qosch/OtterIronProRedesign/ECAD/OtterIronProRedesign.kicad_pcb

## KiCad design ECAD/OtterIronProRedesign.kicad_pcb (2020-11-29)

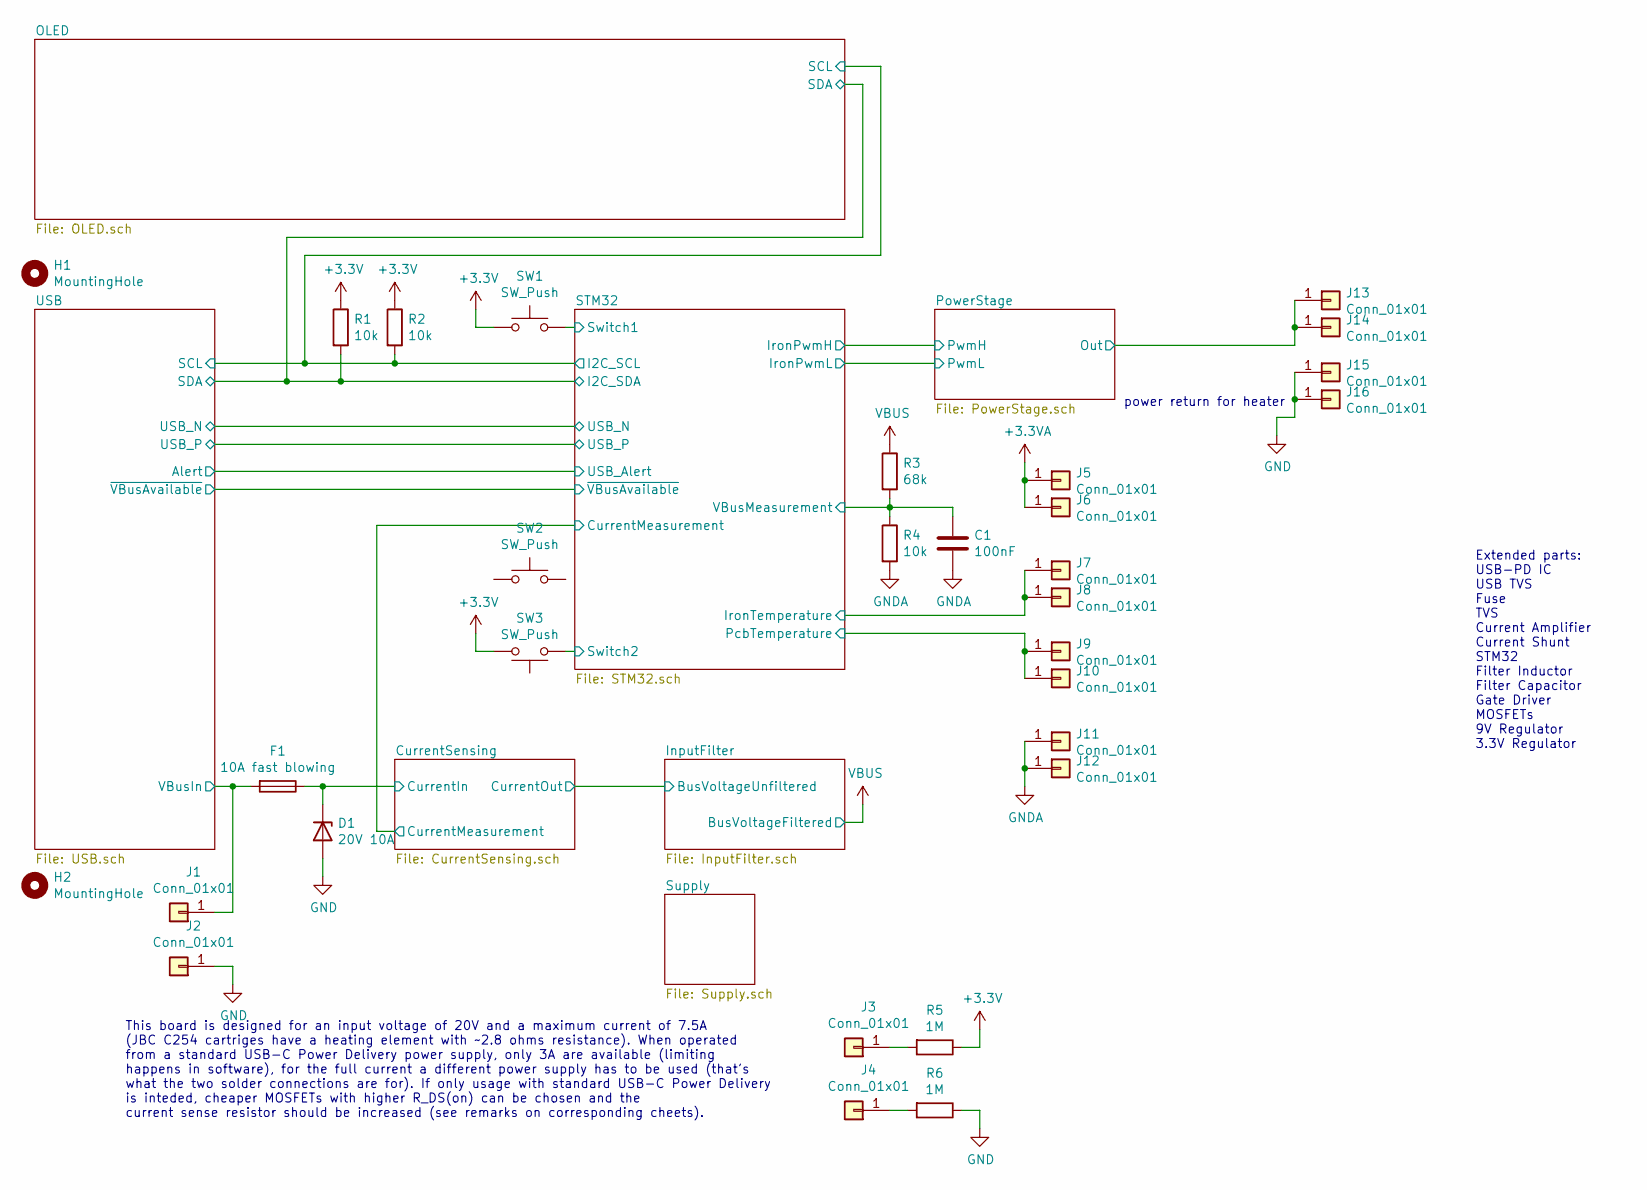
[picture p1: schematic OtterIronProRedesign.sch]

Parts:
C1: 100nF; C_0402_1005Metric
D1: 20V 10A; D_SMB; LCSC C309948
F1: 10A fast blowing; Fuse_1206_3216Metric; LCSC C182976
H1, H2: MountingHole; MountingHole_3.2mm_M3
J1, J2, J3, J4: Conn_01x01; TestPoint_Keystone_5019_Minature
J5, J6, J7, J8, J9, J10, J11, J12, J13, J14, J15, J16: Conn_01x01; TestPoint_Pad_3.0x3.0mm
R1, R2, R4: 10k; R_0402_1005Metric
R3: 68k; R_0402_1005Metric
R5, R6: 1M; R_0402_1005Metric
SW1, SW3: SW_Push; Panasonic_EVQPUL_EVQPUC; LCSC C388883
SW2: SW_Push; SW_Push_1P1T_NO_6x6mm_H9.5mm; LCSC C388883

Connections:
+3.3VA: J5.1, J6.1; also elsewhere on the board
+3V3: R1.1, R2.1, R5.1, SW1.1, SW3.2; also elsewhere on the board
/CurrentSensing/CurrentIn: D1.1 (K), F1.1; also elsewhere on the board
/PowerStage/Out: J13.1, J14.1; also elsewhere on the board
/STM32/I2C_SCL: R2.2; also elsewhere on the board
/STM32/I2C_SDA: R1.2; also elsewhere on the board
/STM32/IronTemperature: J7.1, J8.1; also elsewhere on the board
/STM32/PcbTemperature: J9.1, J10.1; also elsewhere on the board
/STM32/Switch1: SW1.2; also elsewhere on the board
/STM32/Switch2: SW3.1; also elsewhere on the board
/STM32/VBusMeasurement: C1.1, R3.2, R4.1; also elsewhere on the board
/USB/VBusIn: F1.2, J1.1; also elsewhere on the board
GND: D1.2 (A), J2.1, J15.1, J16.1, R6.1; also elsewhere on the board
GNDA: C1.2, J11.1, J12.1, R4.2; also elsewhere on the board
unnamed: J3.1, R5.2
unnamed: J4.1, R6.2
VBUS: R3.1; also elsewhere on the board

Notes on the sheet:
This board is designed for an input voltage of 20V and a maximum current of 7.5A (JBC C254 cartriges have a heating element with ~~2.8 ohms resistance). When operated from a standard USB-C Power Delivery power supply, only 3A are available (limiting happens in software), for the full current a diff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
power return for heater
Extended parts: USB-PD IC USB TVS Fuse TVS Current Amplifier Current Shunt STM32 Filter Inductor Filter Capacitor Gate Driver MOSFETs 9V Regulator 3.3V Regulator

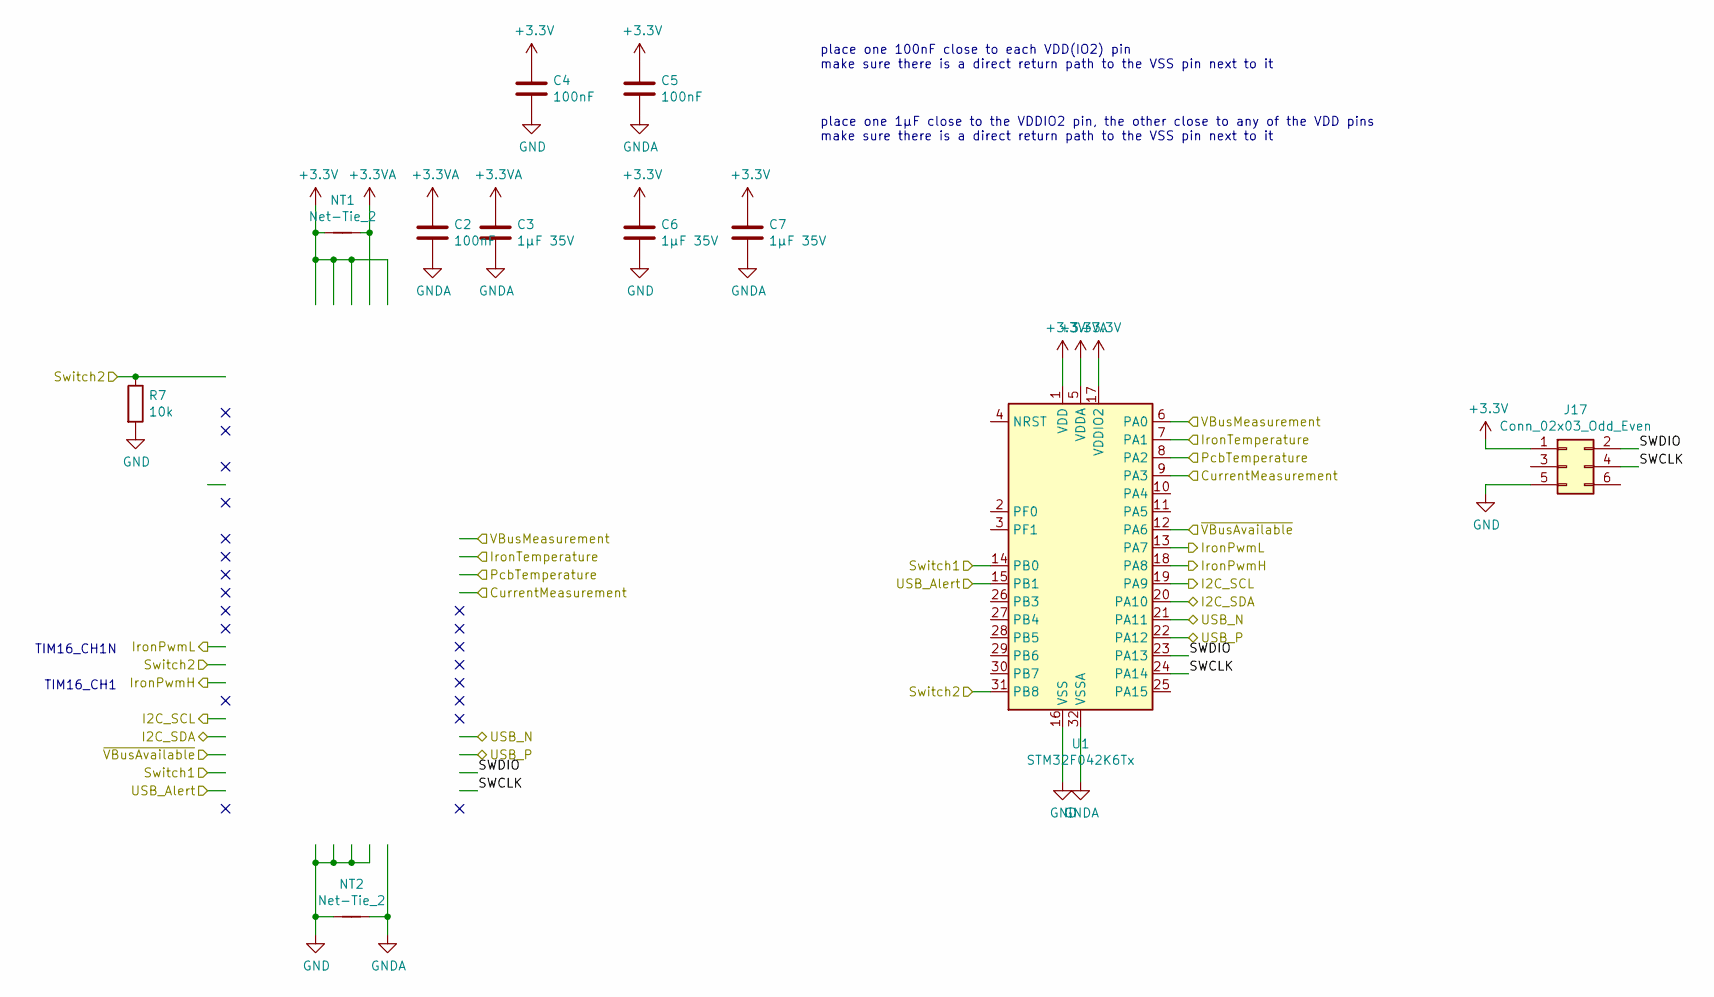
[picture p2: schematic STM32.sch]

Parts:
C2, C4, C5: 100nF; C_0402_1005Metric
C3, C6, C7: 1µF 35V; C_0402_1005Metric
J17: Conn_02x03_Odd_Even; Tag-Connect_TC2030-IDC-NL_2x03_P1.27mm_Vertical
NT1, NT2: Net-Tie_2; NetTie-2_SMD_Pad0.25mm
R7: 10k; R_0402_1005Metric
U1: STM32F042K6Tx; LQFP-32_7x7mm_P0.8mm

Connections:
+3.3VA: C2.1, C3.1, NT1.2, U1.5 (VDDA); also elsewhere on the board
+3V3: C4.1, C5.1, C6.1, C7.1, J17.1, NT1.1, U1.1 (VDD), U1.17 (VDDIO2); also elsewhere on the board
/CurrentSensing/CurrentMeasurement: U1.9 (PA3); also elsewhere on the board
/STM32/I2C_SCL: U1.19 (PA9); also elsewhere on the board
/STM32/I2C_SDA: U1.20 (PA10); also elsewhere on the board
/STM32/IronPwmH: U1.18 (PA8); also elsewhere on the board
/STM32/IronPwmL: U1.13 (PA7); also elsewhere on the board
/STM32/IronTemperature: U1.7 (PA1); also elsewhere on the board
/STM32/PcbTemperature: U1.8 (PA2); also elsewhere on the board
/STM32/SWCLK: J17.4, U1.24 (PA14)
/STM32/SWDIO: J17.2, U1.23 (PA13)
/STM32/Switch1: U1.14 (PB0); also elsewhere on the board
/STM32/Switch2: R7.1, U1.31 (PB8); also elsewhere on the board
/STM32/USB_N: U1.21 (PA11); also elsewhere on the board
/STM32/USB_P: U1.22 (PA12); also elsewhere on the board
/STM32/VBusMeasurement: U1.6 (PA0); also elsewhere on the board
/STM32/~VBusAvailable: U1.12 (PA6); also elsewhere on the board
/USB/Alert: U1.15 (PB1); also elsewhere on the board
GND: C4.2, C6.2, J17.5, NT2.1, R7.2, U1.16 (VSS); also elsewhere on the board
GNDA: C2.2, C3.2, C5.2, C7.2, NT2.2, U1.32 (VSSA); also elsewhere on the board

Notes on the sheet:
place one 100nF close to each VDD(IO2) pin make sure there is a direct return path to the VSS pin next to it
place one 1µF close to the VDDIO2 pin, the other close to any of the VDD pins make sure there is a direct return path to the VSS pin next to it
TIM16_CH1N
TIM16_CH1

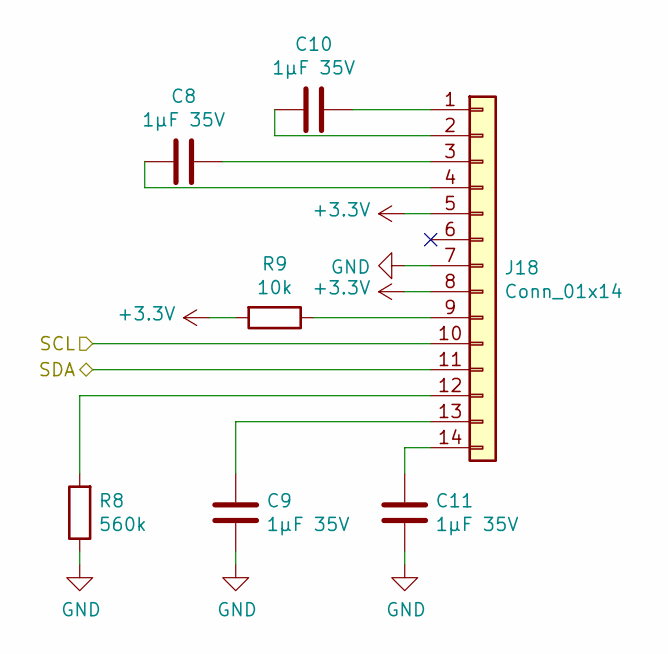
[picture p3: schematic OLED.sch]

Parts:
C8, C9, C10, C11: 1µF 35V; C_0402_1005Metric
J18: Conn_01x14; 0.69OLED
R8: 560k; R_0402_1005Metric
R9: 10k; R_0402_1005Metric

Connections:
+3V3: J18.5, J18.8, R9.2; also elsewhere on the board
/STM32/I2C_SCL: J18.10; also elsewhere on the board
/STM32/I2C_SDA: J18.11; also elsewhere on the board
GND: C9.2, C11.2, J18.7, R8.1; also elsewhere on the board
unnamed: C8.1, J18.3
unnamed: C8.2, J18.4
unnamed: C9.1, J18.13
unnamed: C10.1, J18.1
unnamed: C10.2, J18.2
unnamed: C11.1, J18.14
unnamed: J18.9, R9.1
unnamed: J18.12, R8.2

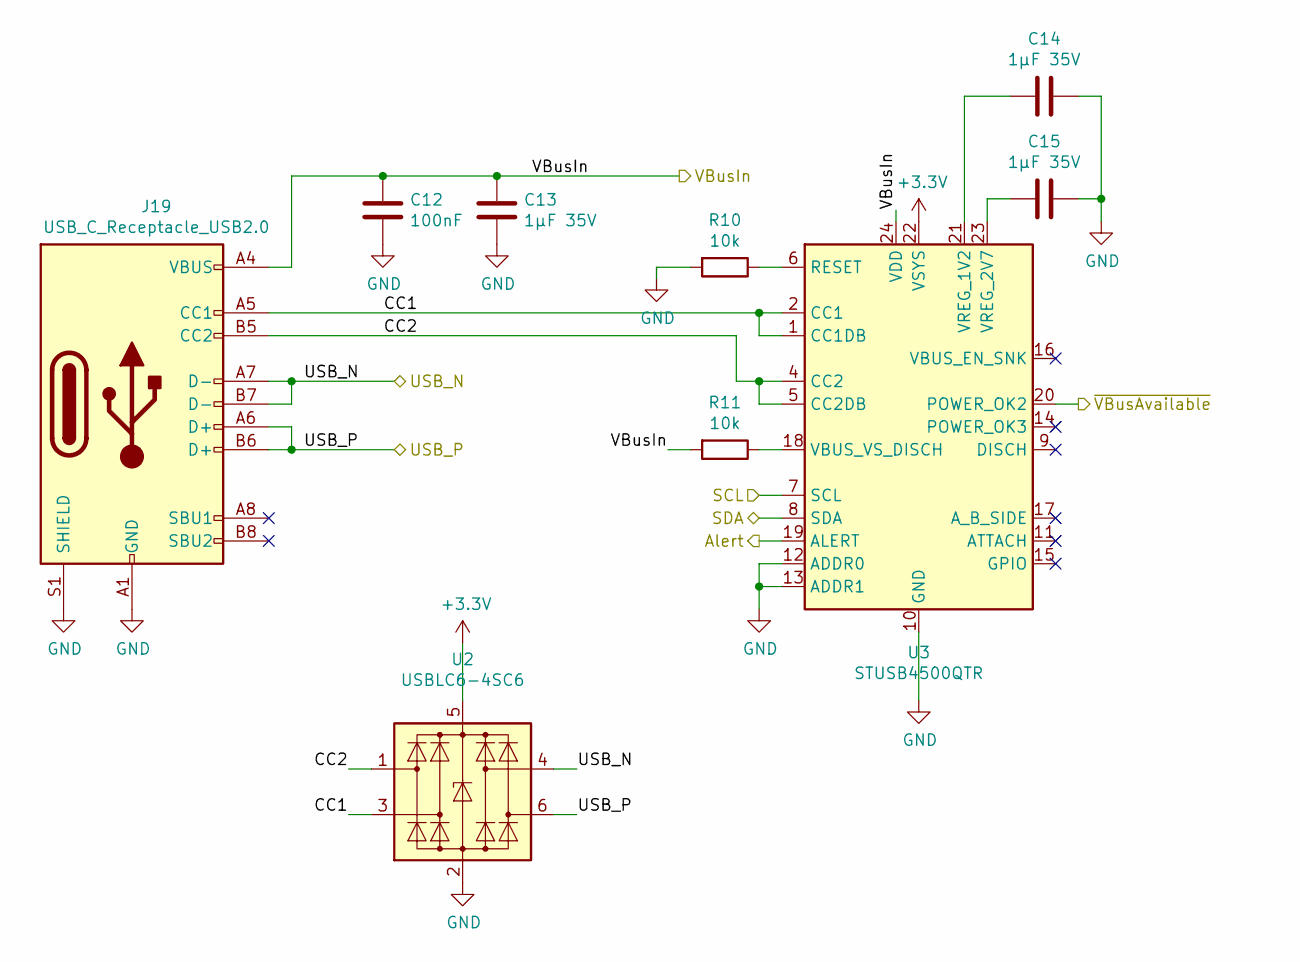
[picture p4: schematic USB.sch]

Parts:
C12: 100nF; C_0402_1005Metric
C13, C14, C15: 1µF 35V; C_0402_1005Metric
J19: USB_C_Receptacle_USB2.0; USB_C_Receptacle_XKB_U262-16XN-4BVC11; LCSC C167321
R10, R11: 10k; R_0402_1005Metric
U2: USBLC6-4SC6; SOT-23-6; LCSC C111212
U3: STUSB4500QTR; QFN-24-1EP_4x4mm_P0.5mm_EP2.7x2.7mm; LCSC C506650

Connections:
+3V3: U2.5 (VBUS), U3.22 (VSYS); also elsewhere on the board
/STM32/I2C_SCL: U3.7 (SCL); also elsewhere on the board
/STM32/I2C_SDA: U3.8 (SDA); also elsewhere on the board
/STM32/USB_N: J19.A7 (D-), J19.B7 (D-), U2.4 (I/O3); also elsewhere on the board
/STM32/USB_P: J19.A6 (D+), J19.B6 (D+), U2.6 (I/O4); also elsewhere on the board
/STM32/~VBusAvailable: U3.20 (POWER_OK2); also elsewhere on the board
/USB/Alert: U3.19 (ALERT); also elsewhere on the board
/USB/CC1: J19.A5 (CC1), U2.3 (I/O2), U3.1 (CC1DB), U3.2 (CC1)
/USB/CC2: J19.B5 (CC2), U2.1 (I/O1), U3.4 (CC2), U3.5 (CC2DB)
/USB/VBusIn: C12.1, C13.1, J19.A4 (VBUS), J19.A9 (VBUS), J19.B4 (VBUS), J19.B9 (VBUS), R11.2, U3.24 (VDD); also elsewhere on the board
GND: C12.2, C13.2, C14.1, C15.1, J19.A1 (GND), J19.A12 (GND), J19.B1 (GND), J19.B12 (GND), J19.S1 (SHIELD), R10.2, U2.2 (GND), U3.10 (GND), U3.12 (ADDR0), U3.13 (ADDR1), U3.25 (GND); also elsewhere on the board
unnamed: C14.2, U3.21 (VREG_1V2)
unnamed: C15.2, U3.23 (VREG_2V7)
unnamed: R10.1, U3.6 (RESET)
unnamed: R11.1, U3.18 (VBUS_VS_DISCH)

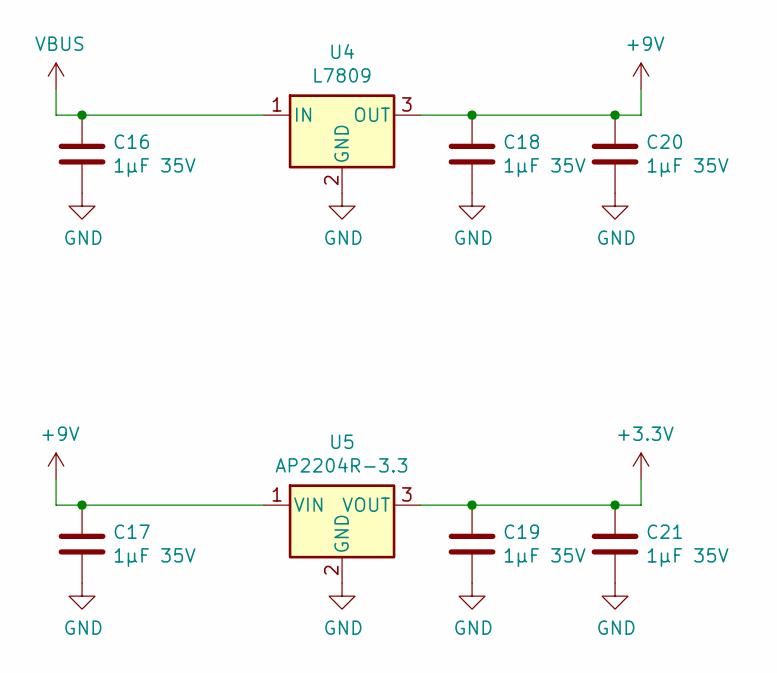
[picture p5: schematic Supply.sch]

Parts:
C16, C17, C18, C19, C20, C21: 1µF 35V; C_0402_1005Metric
U4: L7809; TO-252-2; LCSC C148310
U5: AP2204R-3.3; SOT-89-3

Connections:
+3V3: C19.1, C21.1, U5.3 (VOUT); also elsewhere on the board
+9V: C17.1, C18.1, C20.1, U4.3 (OUT), U5.1 (VIN); also elsewhere on the board
GND: C16.2, C17.2, C18.2, C19.2, C20.2, C21.2, U4.2 (GND), U5.2 (GND); also elsewhere on the board
VBUS: C16.1, U4.1 (IN); also elsewhere on the board

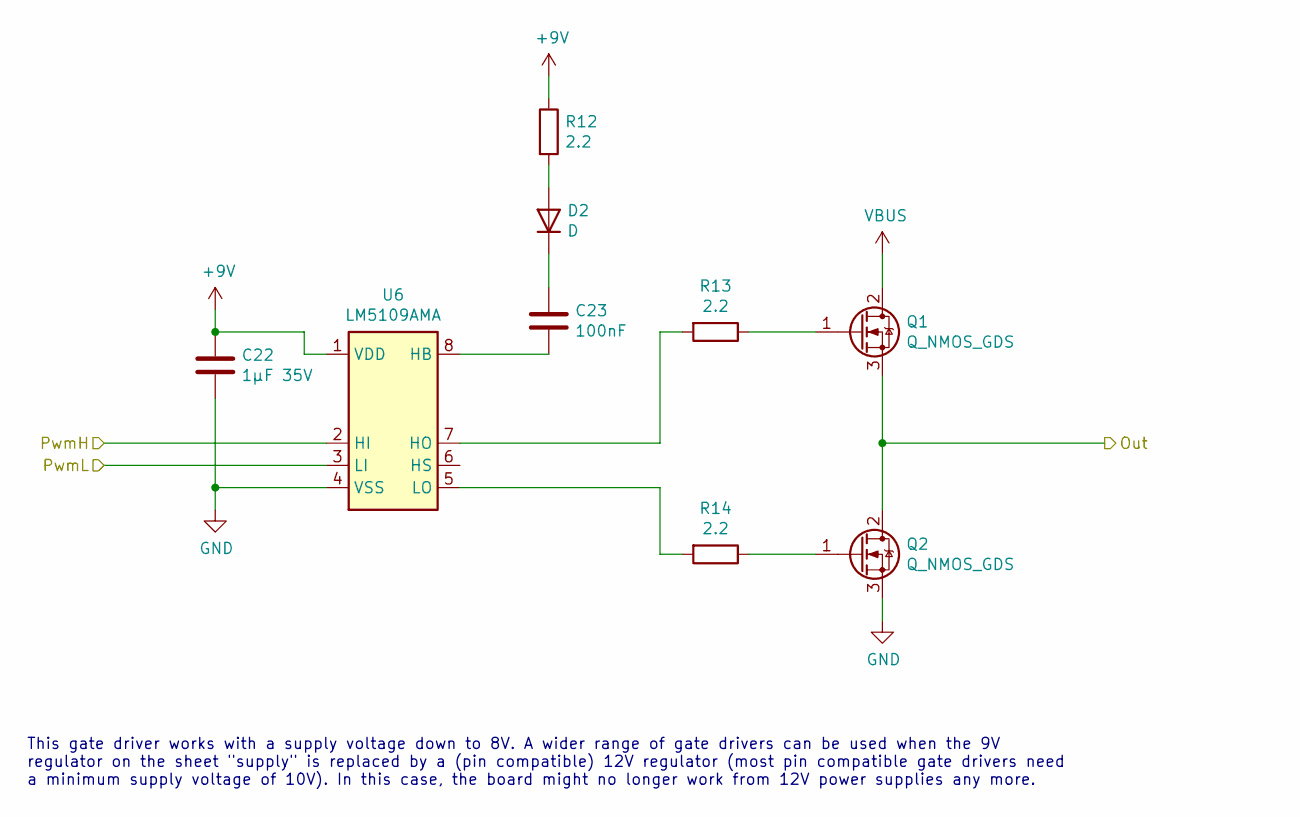
[picture p6: schematic PowerStage.sch]

Parts:
C22: 1µF 35V; C_0402_1005Metric
C23: 100nF; C_0402_1005Metric
D2: D; D_SMA; LCSC C95872
Q1: Q_NMOS_GDS; TO-252-2; LCSC C169754
Q2: Q_NMOS_GDS; TO-252-2
R12, R13, R14: 2.2; R_0402_1005Metric
U6: LM5109AMA; SOIC-8_3.9x4.9mm_P1.27mm; LCSC C129332

Connections:
+9V: C22.1, R12.1, U6.1 (VDD); also elsewhere on the board
/PowerStage/Out: Q1.3 (S), Q2.2 (D); also elsewhere on the board
/STM32/IronPwmH: U6.2 (HI); also elsewhere on the board
/STM32/IronPwmL: U6.3 (LI); also elsewhere on the board
GND: C22.2, Q2.3 (S), U6.4 (VSS); also elsewhere on the board
unnamed: C23.1, D2.1 (K)
unnamed: C23.2, U6.8 (HB)
unnamed: D2.2 (A), R12.2
unnamed: Q1.1 (G), R13.1
unnamed: Q2.1 (G), R14.1
unnamed: R13.2, U6.7 (HO)
unnamed: R14.2, U6.5 (LO)
VBUS: Q1.2 (D); also elsewhere on the board

Notes on the sheet:
This gate driver works with a supply voltage down to 8V. A wider range of gate drivers can be used when the 9V regulator on the sheet "supply" is replaced by a (pin compatible) 12V regulator (most pin compatible gate drivers need a minimum supply voltage of 10V). In this case, the board might no lo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

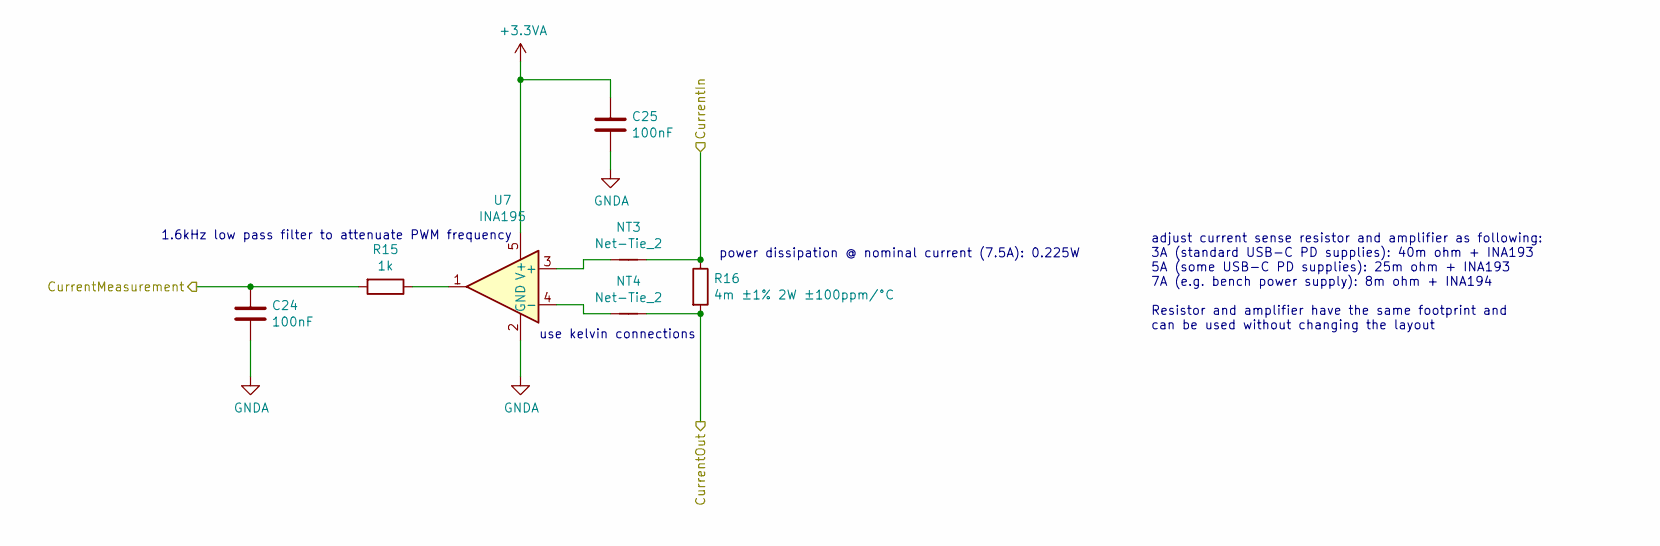
[picture p7: schematic CurrentSensing.sch]

Parts:
C24, C25: 100nF; C_0402_1005Metric
NT3, NT4: Net-Tie_2; NetTie-2_SMD_Pad0.25mm
R15: 1k; R_0402_1005Metric
R16: 4m ±1% 2W ±100ppm/°C; R_2512_6332Metric; LCSC C76237
U7: INA195; SOT-23-5; LCSC C34542

Connections:
+3.3VA: C25.1, U7.5 (V+); also elsewhere on the board
/CurrentSensing/CurrentIn: NT3.2, R16.1; also elsewhere on the board
/CurrentSensing/CurrentMeasurement: C24.1, R15.2; also elsewhere on the board
/InputFilter/BusVoltageUnfiltered: NT4.2, R16.2; also elsewhere on the board
GNDA: C24.2, C25.2, U7.2 (GND); also elsewhere on the board
unnamed: NT3.1, U7.3 (+)
unnamed: NT4.1, U7.4 (-)
unnamed: R15.1, U7.1

Notes on the sheet:
use kelvin connections
power dissipation @ nominal current (7.5A): 0.225W
adjust current sense resistor and amplifier as following: 3A (standard USB-C PD supplies): 40m ohm + INA193 5A (some USB-C PD supplies): 25m ohm + INA193 7A (e.g. bench power supply): 8m ohm + INA194 Resistor and amplifier have the same footprint and can be used without changing the layout
1.6kHz low pass filter to attenuate PWM frequency

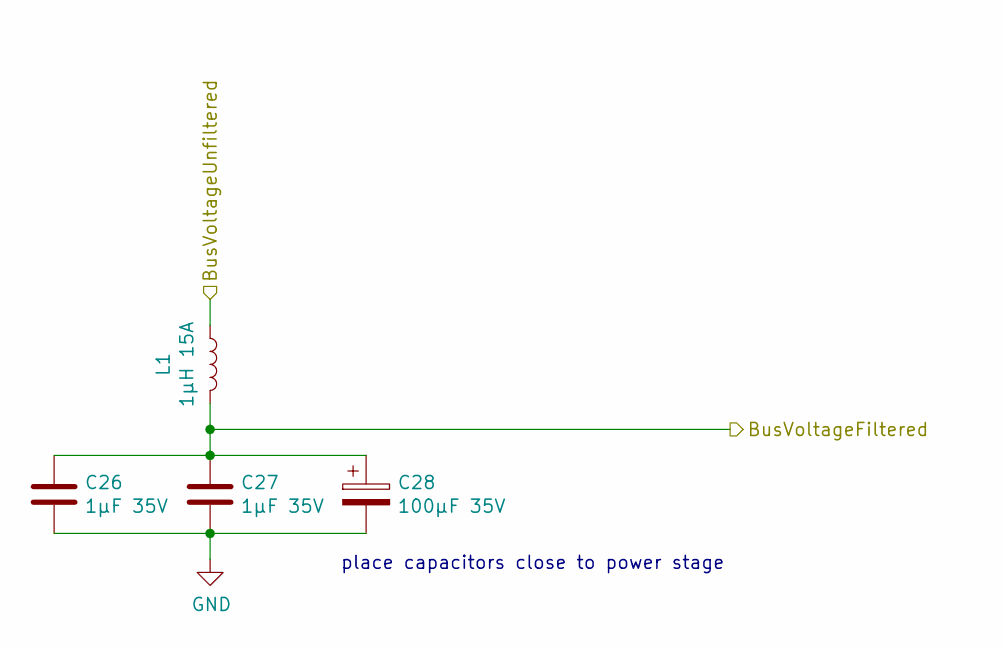
[picture p8: schematic InputFilter.sch]

Parts:
C26, C27: 1µF 35V; C_0402_1005Metric
C28: 100µF 35V; CP_Elec_10x10.5; LCSC C134808
L1: 1µH 15A; L_12x12mm_H8mm; LCSC C149568

Connections:
/InputFilter/BusVoltageUnfiltered: L1.1; also elsewhere on the board
GND: C26.2, C27.2, C28.2; also elsewhere on the board
VBUS: C26.1, C27.1, C28.1, L1.2; also elsewhere on the board

Notes on the sheet:
place capacitors close to power stage

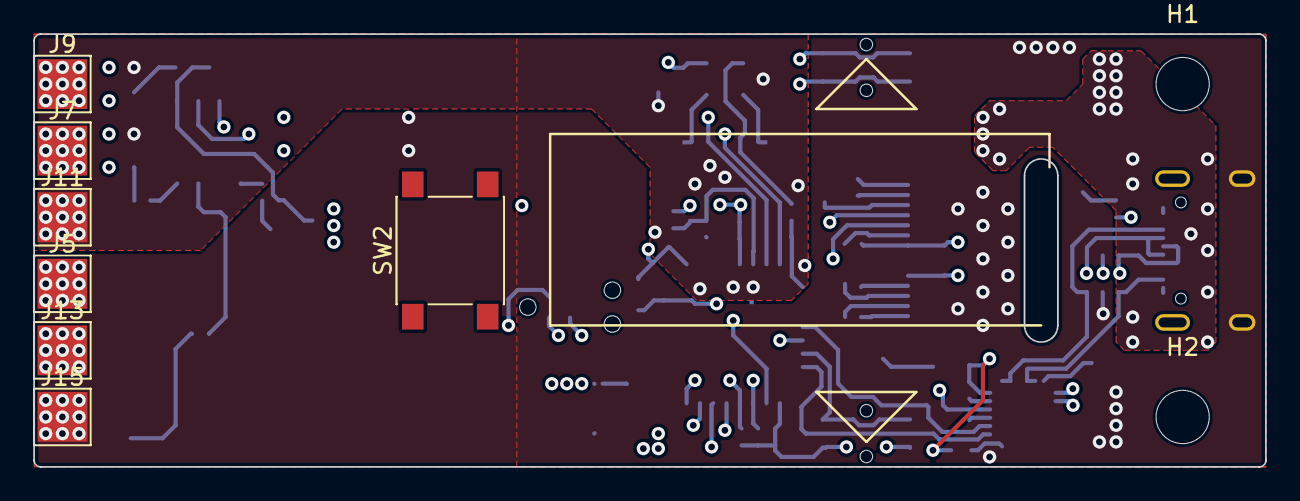
[picture p9: board OtterIronProRedesign.kicad_pcb from above]

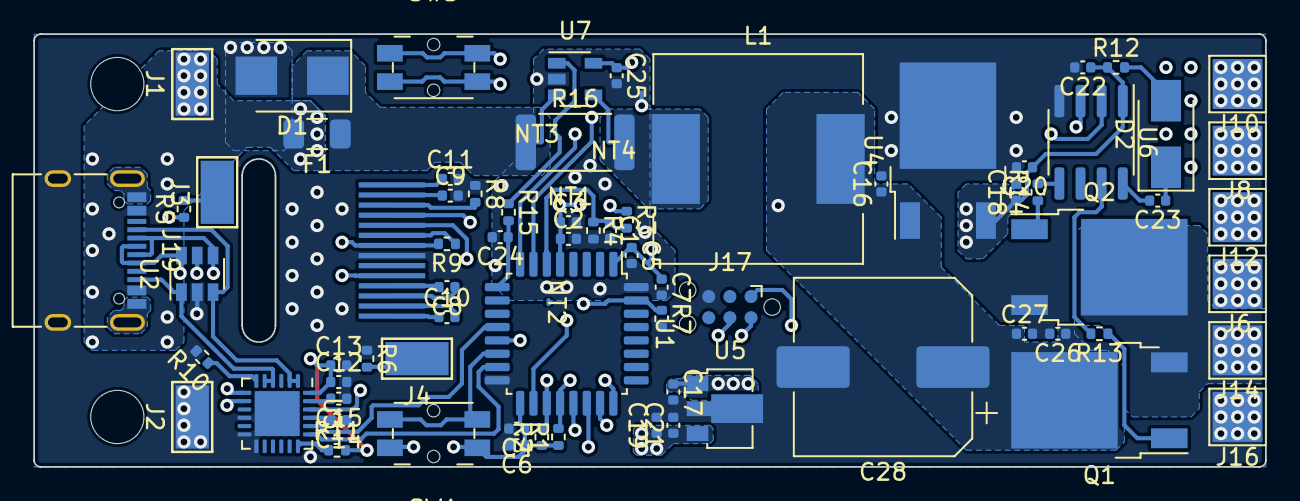
[picture p10: board OtterIronProRedesign.kicad_pcb from below]

Board: 4 copper layers, 74.0 x 26.0 mm, 85 parts (76 on the bottom side), 52 nets.
