qosch/OtterIronProRedesign/(commit log)

2020-11-26 routing almost done
    [CurrentSensing.sch, InputFilter.sch, OLED.sch, OtterIronProRedesign.kicad_pcb, OtterIronProRedesign.sch, PowerStage.sch, STM32.sch, Supply.sch]
2020-11-26 some rearrangements started
    [OtterIronProRedesign.kicad_pcb]
2020-11-29 swapped microcontroller
    [CurrentSensing.sch, InputFilter.sch, OtterIronProRedesign.kicad_pcb, OtterIronProRedesign.sch, STM32.sch]
2020-11-29 forgot to save
    [OtterIronProRedesign.kicad_pcb, STM32.sch]
2020-11-29 more routing + some component changes
    [CurrentSensing.sch, InputFilter.sch, OLED.sch, OtterIronProRedesign.kicad_pcb, OtterIronProRedesign.sch, PowerStage.sch, STM32.sch, Supply.sch]
